jwcxz/glowscape/README.md

Glowscape
=========

glowscape is a simple music visualizer utilizing glowsticks and UV LEDs.

For more information, refer to
[the project overview](http://jwcxz.com/projects/glowscape).
