jwcxz/glowscape/boards/glowscape/glowscape-brd.png

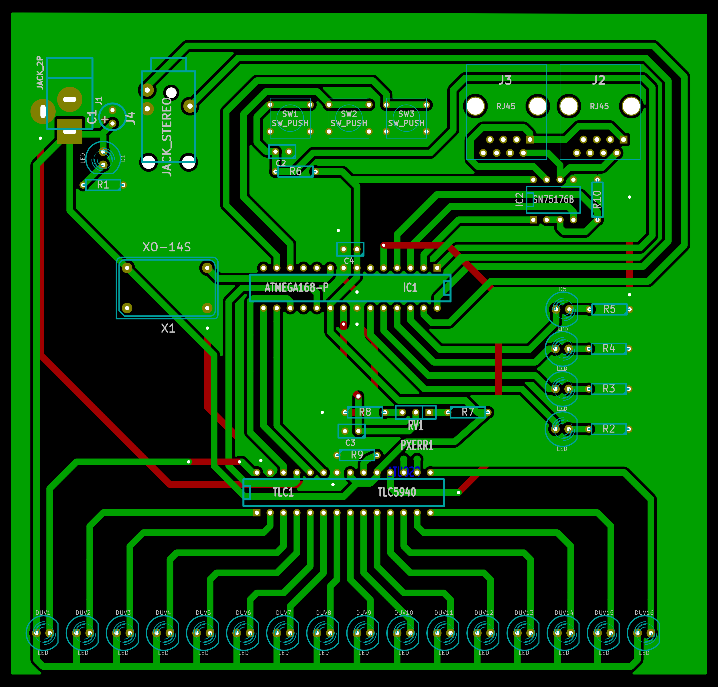
boards/glowscape/glowscape-brd.png
