jwcxz/glowscape/boards/glowscape/glowscape.pdf

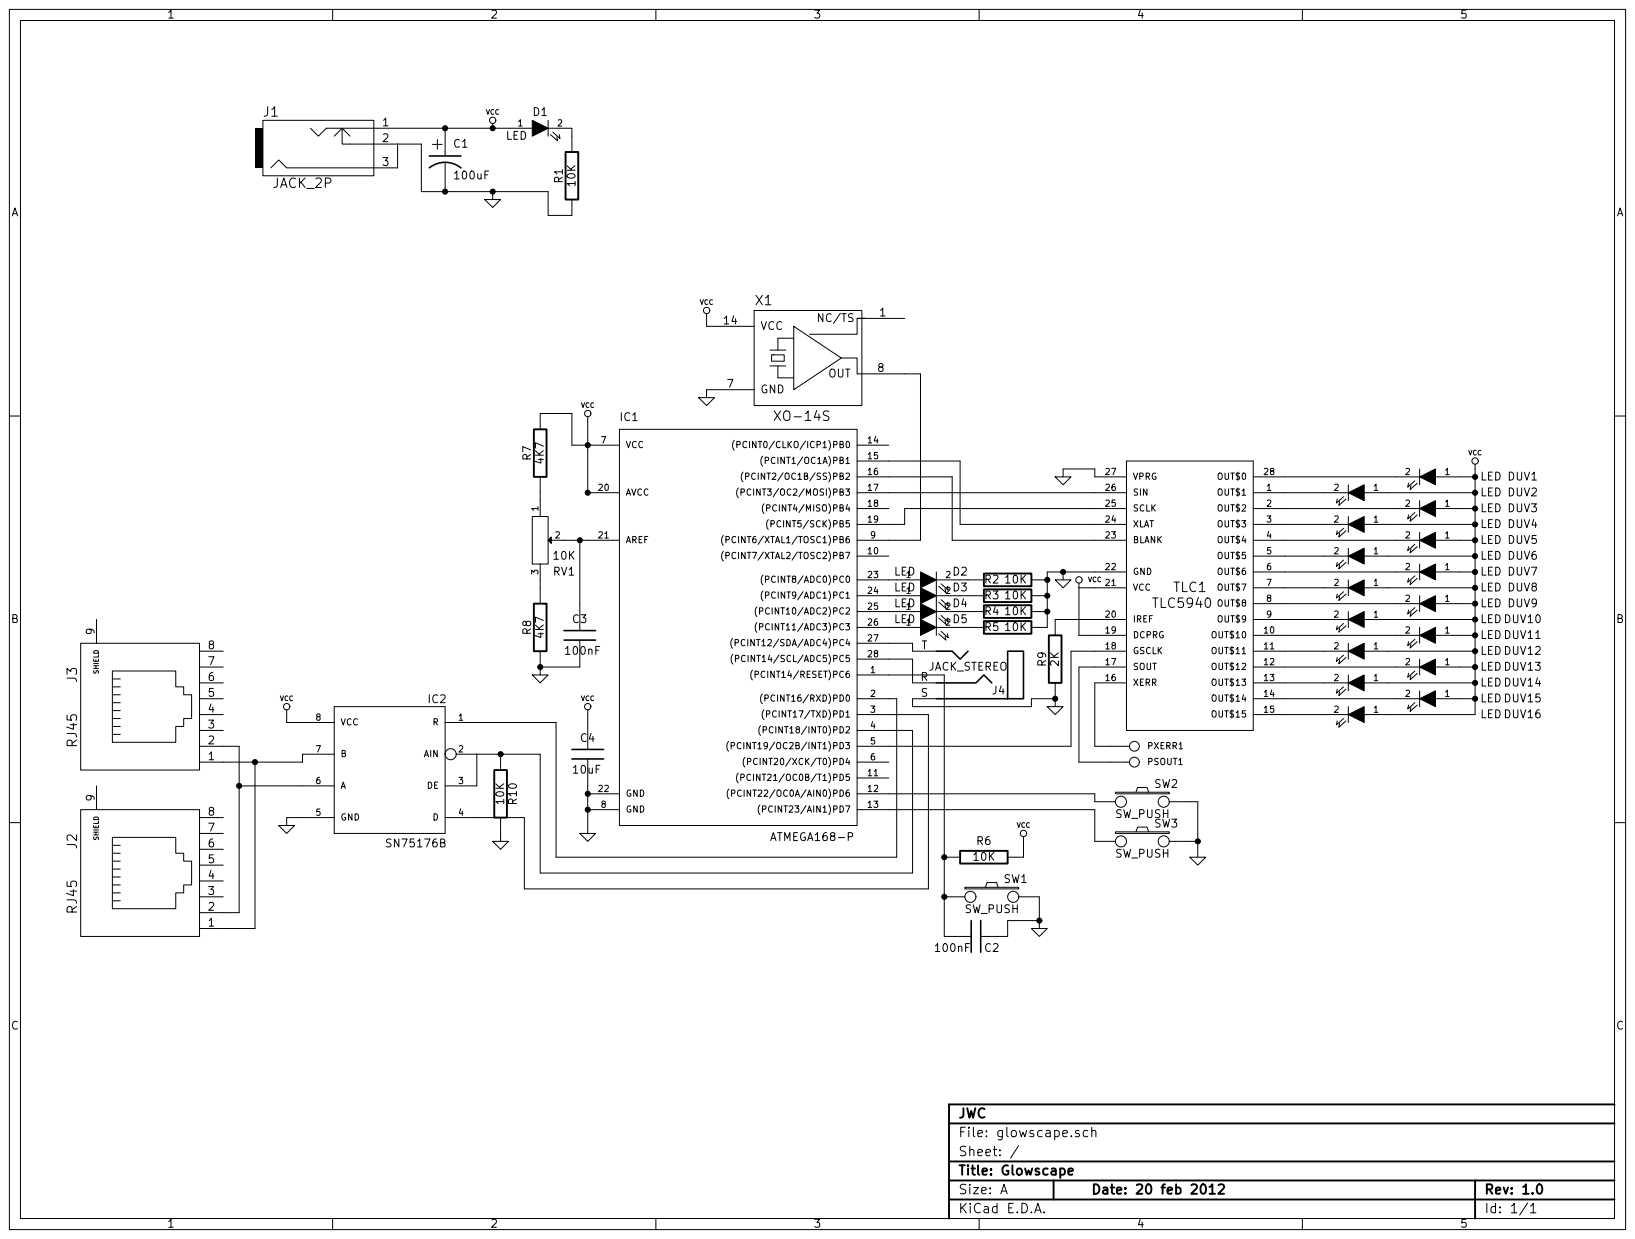
[picture p2: page 1]
