jwcxz/glowscape/boards/glowscape/glowscape-Back.pdf

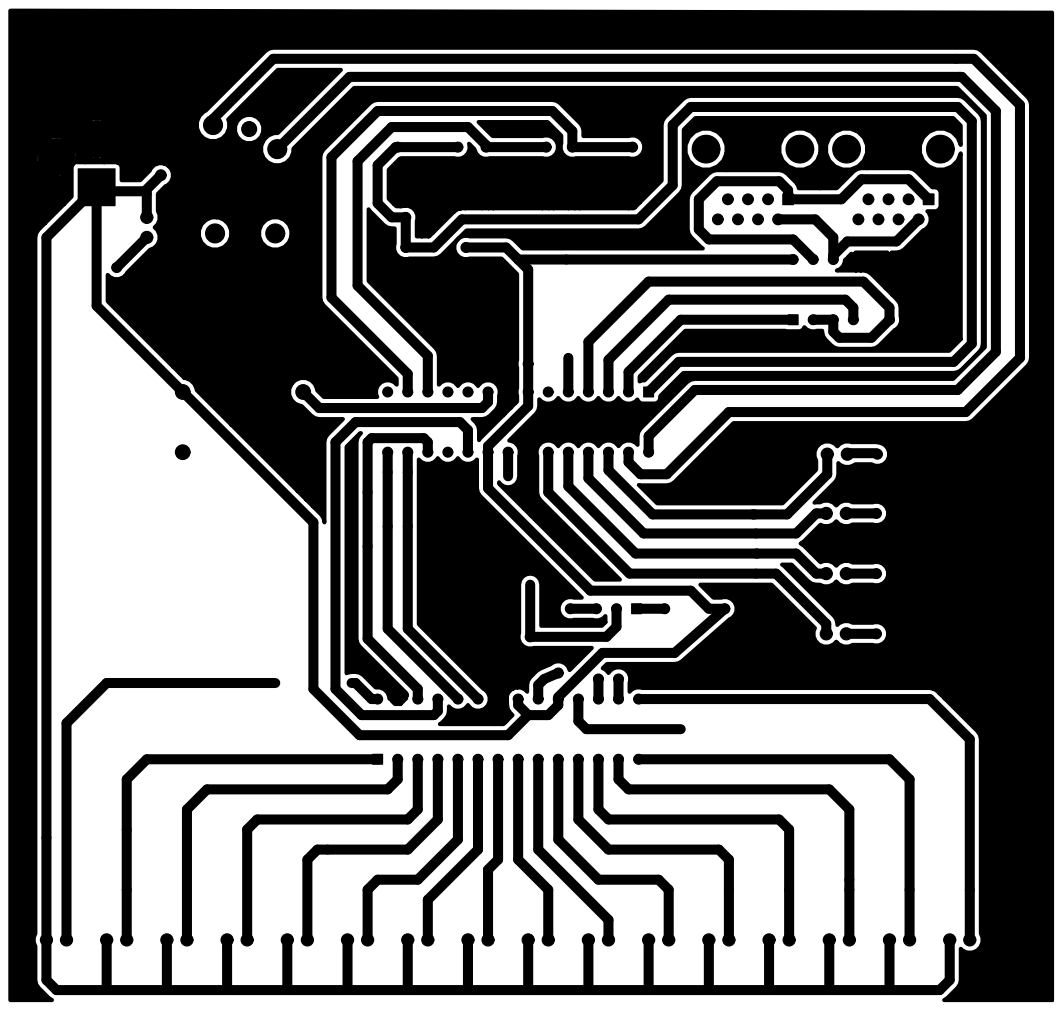
[picture p3: page 1]
