jwcxz/glowscape/boards/glowscape/glowscape.sch

## KiCad design boards/glowscape/glowscape.sch (2012-03-04)

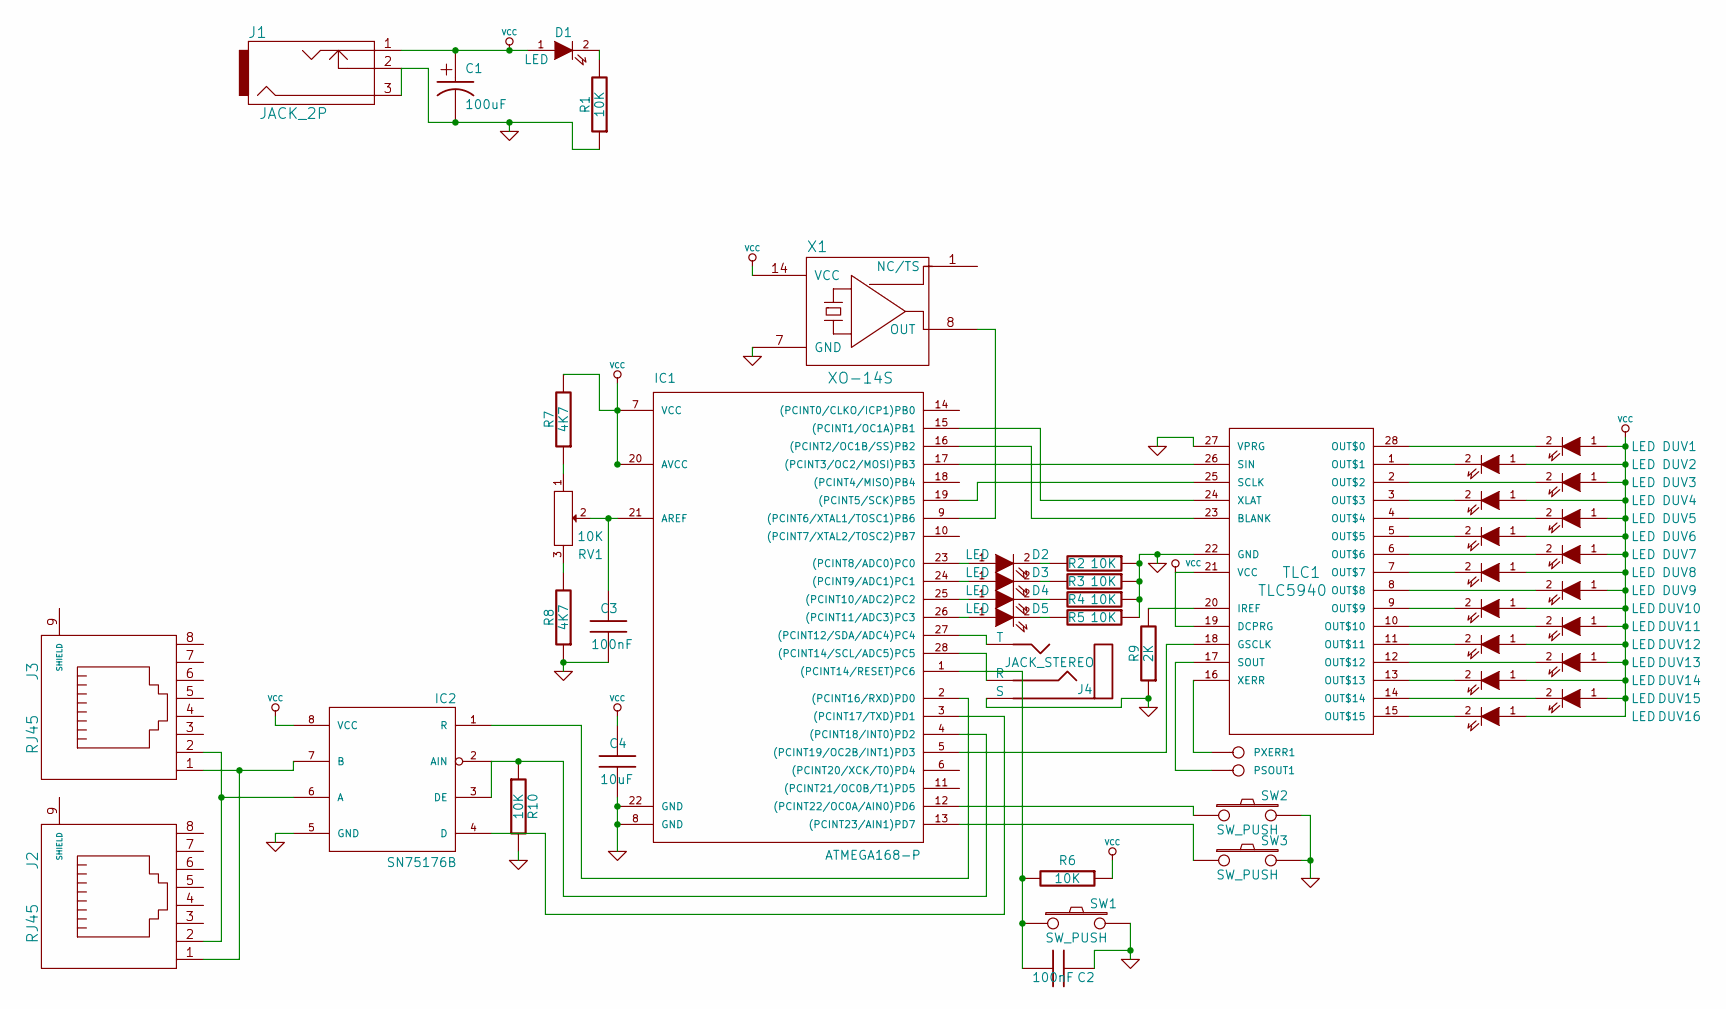
[picture p4: schematic glowscape.sch]

Parts:
C1: 100uF
C2, C3: 100nF
C4: 10uF
D1, D2, D3, D4, D5: LED
DUV1, DUV2, DUV3, DUV4, DUV5, DUV6, DUV7, DUV8, DUV9, DUV10, DUV11, DUV12, DUV13, DUV14, DUV15, DUV16: LED
IC1: ATMEGA168-P; DIL28
IC2: SN75176B; DIL8
J1: JACK_2P
J2, J3: RJ45
J4: JACK_STEREO
PSOUT1: CONN_1
PXERR1: CONN_1
R1, R2, R3, R4, R5, R6, R10: 10K
R7, R8: 4K7
R9: 2K
RV1: 10K
SW1, SW2, SW3: SW_PUSH
TLC1: TLC5940
X1: XO-14S

Connections:
GND: C1.2, C2.1, C3.2, C4.2, IC1.8 (GND), IC1.22 (GND), IC2.5 (GND), J1.2, J1.3, J4.S, R1.1, R2.1, R3.1, R4.1, R5.1, R8.1, R9.1, R10.2, SW1.2, SW2.2, SW3.2, TLC1.22 (GND), TLC1.27 (VPRG), X1.7 (GND)
unnamed: C2.2, IC1.1 ((PCINT14/RESET)PC6), R6.2, SW1.1
unnamed: C3.1, IC1.21 (AREF), RV1.2
unnamed: D1.2 (K), R1.2
unnamed: D2.1 (A), IC1.23 ((PCINT8/ADC0)PC0)
unnamed: D2.2 (K), R2.2
unnamed: D3.1 (A), IC1.24 ((PCINT9/ADC1)PC1)
unnamed: D3.2 (K), R3.2
unnamed: D4.1 (A), IC1.25 ((PCINT10/ADC2)PC2)
unnamed: D4.2 (K), R4.2
unnamed: D5.1 (A), IC1.26 ((PCINT11/ADC3)PC3)
unnamed: D5.2 (K), R5.2
unnamed: DUV1.2 (K), TLC1.28 (OUT$0)
unnamed: DUV2.2 (K), TLC1.1 (OUT$1)
unnamed: DUV3.2 (K), TLC1.2 (OUT$2)
unnamed: DUV4.2 (K), TLC1.3 (OUT$3)
unnamed: DUV5.2 (K), TLC1.4 (OUT$4)
unnamed: DUV6.2 (K), TLC1.5 (OUT$5)
unnamed: DUV7.2 (K), TLC1.6 (OUT$6)
unnamed: DUV8.2 (K), TLC1.7 (OUT$7)
unnamed: DUV9.2 (K), TLC1.8 (OUT$8)
unnamed: DUV10.2 (K), TLC1.9 (OUT$9)
unnamed: DUV11.2 (K), TLC1.10 (OUT$10)
unnamed: DUV12.2 (K), TLC1.11 (OUT$11)
unnamed: DUV13.2 (K), TLC1.12 (OUT$12)
unnamed: DUV14.2 (K), TLC1.13 (OUT$13)
unnamed: DUV15.2 (K), TLC1.14 (OUT$14)
unnamed: DUV16.2 (K), TLC1.15 (OUT$15)
unnamed: IC1.2 ((PCINT16/RXD)PD0), IC2.1 (R)
unnamed: IC1.3 ((PCINT17/TXD)PD1), IC2.4 (D)
unnamed: IC1.4 ((PCINT18/INT0)PD2), IC2.2 (AIN), IC2.3 (DE), R10.1
unnamed: IC1.5 ((PCINT19/OC2B/INT1)PD3), TLC1.18 (GSCLK)
unnamed: IC1.9 ((PCINT6/XTAL1/TOSC1)PB6), X1.8 (OUT)
unnamed: IC1.12 ((PCINT22/OC0A/AIN0)PD6), SW2.1
unnamed: IC1.13 ((PCINT23/AIN1)PD7), SW3.1
unnamed: IC1.15 ((PCINT1/OC1A)PB1), TLC1.24 (XLAT)
unnamed: IC1.16 ((PCINT2/OC1B/SS)PB2), TLC1.23 (BLANK)
unnamed: IC1.17 ((PCINT3/OC2/MOSI)PB3), TLC1.26 (SIN)
unnamed: IC1.19 ((PCINT5/SCK)PB5), TLC1.25 (SCLK)
unnamed: IC1.27 ((PCINT12/SDA/ADC4)PC4), J4.T
unnamed: IC1.28 ((PCINT14/SCL/ADC5)PC5), J4.R
unnamed: IC2.6 (A), J2.2, J3.2
unnamed: IC2.7 (B), J2.1, J3.1
unnamed: PSOUT1.1, TLC1.17 (SOUT)
unnamed: PXERR1.1, TLC1.16 (XERR)
unnamed: R7.1, RV1.1
unnamed: R8.2, RV1.3
unnamed: R9.2, TLC1.20 (IREF)
VCC: C1.1, C4.1, D1.1 (A), DUV1.1 (A), DUV2.1 (A), DUV3.1 (A), DUV4.1 (A), DUV5.1 (A), DUV6.1 (A), DUV7.1 (A), DUV8.1 (A), DUV9.1 (A), DUV10.1 (A), DUV11.1 (A), DUV12.1 (A), DUV13.1 (A), DUV14.1 (A), DUV15.1 (A), DUV16.1 (A), IC1.7 (VCC), IC1.20 (AVCC), IC2.8 (VCC), J1.1, R6.1, R7.2, TLC1.19 (DCPRG), TLC1.21 (VCC), X1.14 (VCC)
