jwcxz/glowscape/avr/glowscape/main.h

/* A C R I S   P R O J E C T ********
 * LED Controller                   *
 * http://jwcxz.com/projects/acris  *
 *                                  *
 * J. Colosimo -- http://jwcxz.com/ *
 *                                  *
 * LED controller main loop         *
 ************************************/

#include "config.h"
#include "macros.h"

#include <inttypes.h>
#include <util/delay.h>
#include <avr/io.h>
#include <avr/interrupt.h>
#include <avr/pgmspace.h>

/* UART BUFFERS */
extern volatile uint8_t uart_rxbuf[UART_RX_BUFSZ];
extern volatile uint8_t *uart_rxbuf_iptr;
extern volatile uint8_t *uart_rxbuf_optr;
extern volatile uint8_t uart_rxbuf_count;
extern volatile uint8_t rxen;

/* XXX: uncomment when enabling TX
extern unsigned char uart_txbuf[UART_TX_BUFSZ];
extern unsigned char *uart_txbuf_iptr = uart_txbuf;
extern unsigned char *uart_txbuf_optr = uart_txbuf;
extern unsigned short int uart_txbuf_count = 0;
*/

/* GLOBAL VARIABLES */
extern uint8_t instaddr;    // instrument address

// tlc driver data holder
// XXX: remove volatile
extern volatile uint8_t tlc[24];

extern uint8_t action;          // current action
extern uint8_t numargs;         // number of arguments to expect
extern uint8_t args[16];        // array to store arguments
extern uint8_t* argptr;         //   ... associated pointer

int main(void);
void receive_data(void);

// state machine states
#define CST_IDLE 0
#define CST_SYNC 1
#define CST_ARGS 2
