jwcxz/glowscape/(commit log)

2012-02-06 started simple board design
    [glowscape.brd, glowscape.sch]
2012-02-20 working on routing the boards
    [$savepcb.brd, glowscape.sch]
2012-02-22 finished first board layout -- should be ready for printing
    [glowscape-unop.brd, glowscape.brd, glowscape.sch]
2012-02-29 finished first board attempt with ground plane
    [$savepcb.brd, glowscape-unop.brd, glowscape.brd]
2012-03-04 cleaned up board stuff
    [$savepcb.brd, glowscape-unop.brd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]
